lihaolun201003/challenging-course/build_ppt/media/screen_real.jpg

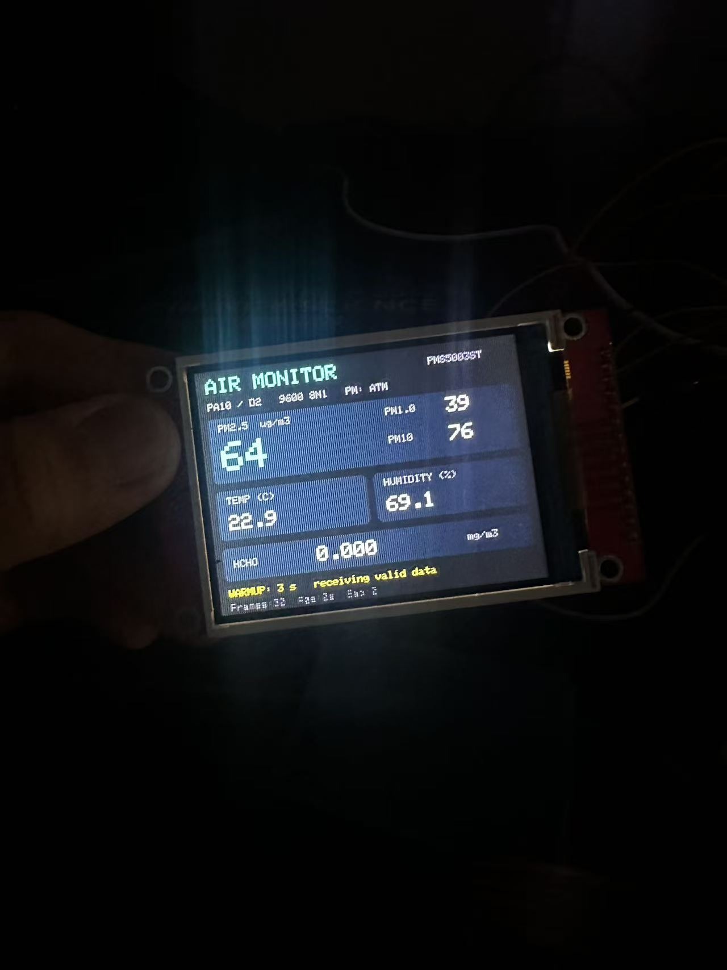
build_ppt/media/screen_real.jpg
