lihaolun201003/challenging-course/build_ppt/media/pcb_layout_early.jpg

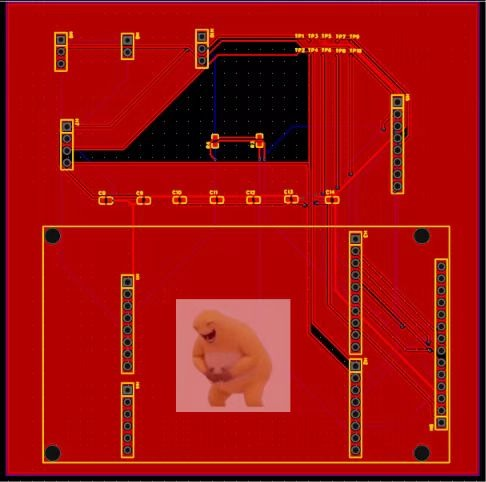
build_ppt/media/pcb_layout_early.jpg
