lihaolun201003/challenging-course/3D外壳打印/外壳初稿_方案A/README.txt

外壳初稿 · 方案 A（v3 · 上盖开显示窗口，屏从外面直接可见）
====================================================================
生成工具：3D 打印外壳生成器｜浮光工具库（内嵌 PrintCasing v0.9.7）
生成日期：2026-10-15

一、这一版做了什么
--------------------------------------------------------------
你要“壳外面正好能露出来显示屏”，所以：
  1. 上盖开了一个显示窗口（实测 68 × 54 mm，见第四节为什么不是 62 × 48）；
  2. 屏幕模块（2.8″ ILI9341，红色 PCB 带排针那款）改到**上盖内侧**、
     与窗口同心，从外面直接看见，不用拆盖；
  3. 外壳加长到 118 mm，把窗口完整放进上盖平面内（不切到墙边）。

二、文件说明
--------------------------------------------------------------
STL\01_底座_带铜柱.stl          底座：Nucleo-64 四铜柱 + 4 个角部螺丝柱        ← 主用
STL\01_上盖_带显示窗口.stl       上盖：显示窗口 + 唇边 + 4 螺丝孔              ← 主用
STL\02_底座_备用版.stl           备用：只保留角螺丝柱，铜柱位置你自己定
STL\02_上盖_备用版.stl           备用：与主用上盖相同（副本）
预览图\外壳_爆炸图.png           应用内截图（看得见上盖的窗口）
预览图\外壳_合盖图.png           应用内截图（合盖）

三、完整参数
--------------------------------------------------------------
[外壳]
  宽度 X ................... 130 mm
  长度 Y ................... 118 mm      （比上一版 +13，为窗口让位）
  高度 Z ................... 50 mm
  壁厚 T ................... 2.4 mm
  圆角半径 ................. 8 mm
  上盖公差 ................. 0.2 mm

[上盖]
  厚度 2.4 mm；唇边 1.6 / 1.5 mm；角部 M3 螺丝固定

[显示窗口]
  位置 ..................... 上盖（开孔 → 目标墙面 = 上盖）
  界面填写 ................. 矩形 62 × 48 mm，中心 x = 0、离前缘 30 mm
  实测结果 ................. 68.0 × 54.0 mm，中心 (0, +22)，即
                             Y 方向 5.0 ~ 59.0 mm（见第四节）

[PCB 安装]
  STM32 Nucleo-64 预设（孔距 70 × 50 mm）；底座内底面；旋转 90°；
  铜柱高 8 mm；中心偏移 Y = −28 mm（板子前移，后腔走线）

[通风] 本版未开槽（原因见第五节）

四、为什么界面填 62×48、实测却是 68×54
--------------------------------------------------------------
这个工具的开孔位置/尺寸有一套隐含换算，我做了 4 组标定实验才量准：
  · 宽度方向：实测宽 = 壳宽 − 填写宽。填 62 → 68 mm。想精确要 62，
    需要把宽度填成 68（但那会让窗口几乎占满上盖宽度，反而危险）。
  · 高度方向：填 48 → 实测 54；填 42 → 48。所以**高度是准的、宽度有 +6 的偏差**。
  · 位置：填写 z 控制窗口中心到前缘的距离。
结论：本版取“宁大不小”——窗口 68 × 54，屏幕可视区 57.6 × 43.2 一定能完整露出，
四周留 5 mm 左右遮边。**如果你要窗口刚好 62 × 48**，把宽度改成 68、
高度改成 42 再导出一版即可，或者告诉我，我帮你出。

五、几何自检（实测）
--------------------------------------------------------------
底座：3,082 三角面，包围盒 130.000 × 118.000 × 50.000 mm，体积 103.68 cm³，
      零退化三角形，1e-4 精度下 4 条缝合边（0.001 mm 量级，切片器自动缝合）。
上盖：1,404 三角面，体积 33.83 cm³，零退化三角形，窗口干净、无水密性障碍。
界面读数一致：底座 128.6 g + 上盖 42.0 g = 170.6 g（PLA 1.24 g/cm³）。

六、传感器（PMS5003ST）通风 —— 仍留给你手工做
--------------------------------------------------------------
原因同上一版：这个工具的“通风槽”是居中贯穿整块板的，一开就切进窗口区域。
位置建议（上盖后半区，窗口后沿之后）：
  X 左右各 15 ~ 40 mm、Y 窗口后沿 +5 ~ 到内壁前 5 mm 范围内，
  开 6 ~ 8 个 Ø3 ~ 4 mm 圆孔，左右两排、前后错开；传感器就挂在这一片内侧。
做法：① 手电钻按位置打；② 切片软件“负零件/修改器”加孔后重切片（推荐，不引入缝合边）；
      ③ 要工具直接生成，就把外壳再拉长、让槽居中落在窗口之外，我帮你出。

七、装配要点
--------------------------------------------------------------
0. 先量实物再打第一版：① Nucleo 两块板孔距（70×50 还是 70×63.5）；
   ② 屏幕模块的四个安装孔距。量完告诉我，我按实测改。
1. 屏幕固定：模块外框约 58 × 87 mm（按实物照像素折算，误差 ±2 mm）。
   模块四角用 M3 尼龙柱/铜柱固定在上盖内侧，或用打印压条压住；
   屏幕面与窗口之间留 1 mm 泡棉垫，防尘缓冲。
2. 屏幕排线从窗口后沿走到后腔，再经侧墙缺口进底盒接 Nucleo。
3. 铜柱中心 ±25 / ±35 mm，距内壁约 0.4 mm，装板注意别顶到圆角。
4. Nucleo 的 USB、传感器线束、蜂鸣器声孔按实机位置自己开。

八、下一步
--------------------------------------------------------------
- 想要“窗口刚好 62×48”：填宽度 68、高度 42 重新导出（或用我给的参数）。
- 想要“屏幕面凸出上盖 1~2 mm”的面板样式：把铜柱高度从 8 调到 10~12 再导出。
- 需要我把通风孔直接做进 STL（外壳再加长 20 mm）或改成屏幕外凸样式，说一声。
