lihaolun201003/challenging-course/02_固件工程/AIR/docs/Naiwa-companion-ui.md

# 奶娃陪伴固件：已修改并烧录

烧录完成：2026-10-16T00:03:29.032617+08:00。

已将“奶娃陪伴”界面接入工程 `C:\Users\lihao\Desktop\挑战性课程\02_固件工程\AIR`，并通过ST-Link烧录到当前连接的NUCLEO-F411RE。
界面为320×240横屏，奶油黄背景，左侧奶娃与中文状态，右侧六参数对齐读数，底部真实数据年龄及蓝牙上报状态。角色默认静态，数字和状态按变化局部更新。原启动动画保留。

## 验证结果

- PlatformIO环境：nucleo_f411re_uart6，构建成功。
- 固件BIN：329312字节；Flash报告328856/524288，RAM报告89016/131072。
- OpenOCD显示Verified OK；烧录后读回完整应用范围，与BIN逐字节一致。
- 新UI标识和BOOT monitor: ready均出现，启动次数1。
- 115200 8N1、COM3，连续观察45秒，收到48帧；帧号连续，传感器ERR非零次数0。
- 诊断记录8条；校验错误、长度错误、半帧超时均为0。
- 最后一帧：PM1.0=30、PM2.5=48、PM10=58 µg/m³，温度22.7°C，湿度68.4%RH，甲醛0.000 mg/m³。这是烧录后运行检查，不是新的10分钟实验。
- 原有文件只修改src/main.cpp；原传感器解析、蓝牙、报警逻辑、引脚配置和启动动画文件哈希保持一致。
- 未通过相机检查实屏画面；验证覆盖编译、实际烧录/读回与新固件运行日志。

## 文件与回退

- `air-naiwa-companion-uart6-20261016.bin/.elf`：实际烧录的新固件。
- `验证记录.json`：机器可读结果；烧录和串口日志另附。
- `源码改动.zip`：UI集成main与新增模块、资源生成脚本及角色源图。
- `烧录前备份.zip`：修改前完整Flash、源码和恢复说明。
- 工程内归档：firmware/air-naiwa-companion-uart6-20261016.bin、firmware/air-naiwa-companion-uart6-20261016.elf。
- 工程内备份：backups/before-naiwa-companion-20261015_235608。

新固件SHA-256：`bef9a11d3dc791f4b05b4394965e82e0bf207f11f094a73bd3b0560aed887c59`。
