lihaolun201003/challenging-course/00_整理记录/整理报告.md

# 整理记录

**整理日期**：本次会话
**整理范围**：`C:\Users\lihao\Desktop\挑战性课程`
**用户要求**：**都不删，就整理** —— 因此本次**没有删除任何一个文件**，只做搬迁、重命名与归类。

---

## 一、结果：零丢失（已逐字节校验）

整理前后对全部文件做了 SHA-256 指纹，逐一比对：

| | 文件数 | 总字节数 |
| --- | --- | --- |
| 整理前 | **2477** | **45,277,537** |
| 整理后 | **2477** | **45,277,537** |
| 丢失（有前无后） | **0** | — |
| 新增（有后无前） | **0** | — |

> 校验方法：遍历全部文件计算 SHA-256，用多重集（multiset）比对，
> 因此"内容相同但路径变了"不会被误判为丢失。
> 完整清单见同目录的 [文件清单_整理前.tsv](文件清单_整理前.tsv) 与 [文件清单_整理后.tsv](文件清单_整理后.tsv)。

唯一被移除的是**空目录** `AIR(1)\AIR\`（搬迁后剩下 0 个文件的外壳）。

> 说明：外层空壳 `AIR(1)\` 当时被系统的其他进程占用（Explorer / 索引器持有句柄），
> 未能删除，现在仍留在根目录，**里面 0 个文件**，你可以直接手动删掉它。

---

## 二、搬迁对照表

### 根目录散落文件 → 分类目录

| 原路径 | 新路径 | 说明 |
| --- | --- | --- |
| `挑战性课程开题报告.pptx` | `01_报告/01_开题报告.pptx` | |
| `挑战性课程阶段性报告.pptx` | `01_报告/02_阶段性报告.pptx` | |
| `演示文稿1(2).pptx` | `01_报告/03_PCB迭代记录.pptx` | 内容是 PCB 原理图 + 三版布局 |
| `document.tex` | `03_外设接口说明/外设接口分配表.tex` | 内容未改 |
| `stm32.pdf` | `04_资料/NUCLEO-64_用户手册.pdf` | 91 页 |
| `显示屏.pdf` | `04_资料/ILI9341_显示屏资料.pdf` | 8 页 |
| `4cfd53e59920ec299d00e6085c6228a6.png` | `05_素材/APP_MIT_AppInventor设计界面.jpg` | 改名 + **修正错误扩展名** |
| `微信图片_20260922125235_5_2.jpg` | `05_素材/APP_手机运行截图.jpg` | 改名 |
| `8d35c32eb0cca47f893ce5399ef7c01f.jpg` | `05_素材/实物_屏幕实时读数.jpg` | 改名 |
| `微信图片_20260922125316_6_2.jpg` | `05_素材/PCB_布局截图.jpg` | 改名 |
| `d50e7ac4a7a0a84cb1c2305e1b7adbf0.mp4` | `05_素材/实物演示视频.mp4` | 改名 |

### 固件工程

| 原路径 | 新路径 | 说明 |
| --- | --- | --- |
| `AIR(1)\AIR\AIR\` | `02_固件工程\AIR\` | **去掉两层多余嵌套**，工程内部结构一个文件都没动 |

---

## 三、新建的文件（全部是新增说明文档，未覆盖任何原文件）

| 文件 | 作用 |
| --- | --- |
| `README.md`（根目录） | 总导航 + 三十秒上手 + 已知待修正事项 |
| `00_整理记录/整理报告.md` | 本文件 |
| `00_整理记录/文件清单_整理前.tsv` / `_整理后.tsv` | 零丢失校验的原始数据 |
| `05_素材/清单.md` | 每张图 / 视频的内容、尺寸、是否已嵌入 PPT |
| `02_固件工程/AIR/firmware/MANIFEST.md` | 12 个固件产物 ↔ PlatformIO 环境 ↔ SHA-256 ↔ 验证日志 |
| `02_固件工程/AIR/logs/README.md` | 46 个日志按 9 组归类索引 |

另：根目录初始化了一个 **git 仓库**并提交了整理前的完整快照
（commit `4e0494d` "整理前快照：原样保存 2477 个文件"），作为本次搬迁的撤销点。
**不需要的话直接删掉 `.git` 文件夹即可**，不影响任何内容。
（`.pio` 构建缓存按工程原有的 .gitignore 规则未纳入版本管理。）

---

## 四、明确没做的事

本次严格遵循"都不删、就整理"，以下一律**未改动**：

- ❌ 未删除任何文件
- ❌ 未修改任何原有文件的内容（含 PPT、PDF、.tex、源码、日志）
- ❌ 未修改 `src/`、`include/`、`test/`、`platformio.ini`
- ❌ 未修改 `backups/` 里 8 个快照的内容
- ❌ 未清理 `.pio` 构建缓存（虽然它是可再生的，但你说不删）
- ❌ 未修正 `document.tex` 的引脚错误、未修正 PPT 笔误（只在根 README 里记录下来）

---

## 五、搬迁后回归验证

| 项目 | 结果 |
| --- | --- |
| 在新位置编译默认固件 | ✅ `pio run -e nucleo_f411re_uart6` → **SUCCESS**（全量重建 6.94 s） |
| 资源占用是否变化 | ✅ 与搬迁前完全一致：Flash **48144 B (9.2%)**、静态 RAM **8988 B (6.9%)** |
| 重建产物与存档固件是否一致 | ✅ SHA-256 均为 `46f820447f180d37c6e09040c288e3cfa7c6b1ff00bfdb3798784ae9f17a162d` —— **字节完全相同** |
| 中文路径是否有影响 | ✅ 无影响（工程自带 `scripts/windows_paths.py` 处理 Unicode 链接路径） |

---

## 六、遗留事项

见根目录 [README.md](../README.md) 的"⚠️ 已知待修正事项"一节，共 5 条，
其中优先建议处理的是 **`外设接口分配表.tex` 与当前固件接线不一致**
（蓝牙串口、LCD 的 DC/RESET/背光、PMS 的 SET/RESET 都对不上）。
