lihaolun201003/challenging-course/02_固件工程/数据包/光电楼_20261021_151032/summary.md

# 串口采集观察摘要

> 仅描述记录到的现象；不设置通过标准，不验证传感器精度。

- 数据：`measurements.csv`，共 **642** 行；保留零值，不插值、不滤波、不删除异常读数。
- 元数据正式窗口：2026-10-21T15:11:03.303+08:00 至 2026-10-21T15:21:03.303+08:00；声明时长 **600 s**。
- 实际首末读数：**2026-10-21T15:11:03.697+08:00** 至 **2026-10-21T15:21:02.942+08:00**。
- 样本覆盖：**599.2451 s**（elapsed_s）；首末样本跨度与正式计时窗口分别记录，二者可以不同。
- 元数据原值：source_code_unchanged=—；flash_verified=—。缺失/未确认不视为true。

## 数值统计

| 参数 | 单位 | 数值数 | 零值数 | 最小 | 最大 | 平均 | 样本标准差 | 缺失/非法 |
| --- | --- | ---: | ---: | ---: | ---: | ---: | ---: | ---: |
| PM1.0 | µg/m³ | 642 | 554 | 0 | 19 | 0.7165 | 3.0396 | 0/0 |
| PM2.5 | µg/m³ | 642 | 492 | 0 | 29 | 1.1589 | 4.6379 | 0/0 |
| PM10 | µg/m³ | 642 | 486 | 0 | 32 | 1.2508 | 5.0718 | 0/0 |
| 甲醛 HCHO | mg/m³ | 642 | 642 | 0 | 0 | 0 | 0 | 0/0 |
| 温度 | °C | 642 | 0 | 19.8 | 20.8 | 20.3693 | 0.2809 | 0/0 |
| 相对湿度 | % | 642 | 0 | 56.6 | 62.1 | 60.1713 | 0.9459 | 0/0 |

标准差使用ddof=1；缺失/非数值/非有限值如实计数，不转成0。原始CSV不被修改。

## 主机接收间隔与帧编号

- 相邻接收间隔 min / median / max / p95：**0.9011 / 0.9083 / 0.9851 / 0.9791 s**；p95使用nearest-rank。
- 窗口起点至首样：0.394 s；末样至窗口终点：0.3609 s；包含两端的最长可观察无读数区间：**0.9851 s**。
- 达到或超过10秒的区间共 **0** 个（含可评估的窗口边缘）；明细见summary.json。
- 零间隔 0 次；负间隔 0 次；时间无法比较的相邻记录 0 对。
- 帧编号首/末：403 / 1044；相邻重复 0 次，向前跳号 0 次（未见编号 0 个），回退 0 次。
- ERR非零 **0** 次；ERR缺失/非法 0 次；固件版本原值分布：`{"145": 642}`。

## 原始诊断计数

全部诊断记录：2026-10-21T15:10:37.600+08:00 → 2026-10-21T15:21:07.605+08:00，记录跨度 630.0059 s。

| 原始累计项 | 首值 | 末值 | 末减首 | 期间回退次数 |
| --- | ---: | ---: | ---: | ---: |
| 接收字节数 | 15000 | 41941 | 26941 | 0 |
| 有效帧数 | 375 | 1048 | 673 | 0 |
| 校验错误数 | 0 | 0 | 0 | 0 |
| 长度错误数 | 0 | 0 | 0 | 0 |
| 半帧超时数 | 0 | 0 | 0 | 0 |

仅phase=test的记录：2026-10-21T15:11:07.600+08:00 → 2026-10-21T15:21:02.606+08:00，记录跨度 595.0058 s。

| 原始累计项 | 首值 | 末值 | 末减首 | 期间回退次数 |
| --- | ---: | ---: | ---: | ---: |
| 接收字节数 | 16280 | 41720 | 25440 | 0 |
| 有效帧数 | 407 | 1043 | 636 | 0 |
| 校验错误数 | 0 | 0 | 0 | 0 |
| 长度错误数 | 0 | 0 | 0 | 0 |
| 半帧超时数 | 0 | 0 | 0 | 0 |

测试边缘外包记录：2026-10-21T15:11:02.600+08:00 → 2026-10-21T15:21:07.605+08:00，记录跨度 605.0057 s。

| 原始累计项 | 首值 | 末值 | 末减首 | 期间回退次数 |
| --- | ---: | ---: | ---: | ---: |
| 接收字节数 | 16040 | 41941 | 25901 | 0 |
| 有效帧数 | 401 | 1048 | 647 | 0 |
| 校验错误数 | 0 | 0 | 0 | 0 |
| 长度错误数 | 0 | 0 | 0 | 0 |
| 半帧超时数 | 0 | 0 | 0 | 0 |

## 边界与解释

- 正式计时窗口来自元数据，实际样本覆盖来自首末CSV读数，两者不是同一时长；不足600秒的样本跨度不自动否定600秒采集窗口。
- 全部measurements.csv记录参与分析；不插值、不平滑、不重采样、不删除零或ERR非零读数。非法/缺失值保持缺失并单列数量。
- 相邻主机接收间隔优先由elapsed_s相减；不可用时才用可比较的timestamp_local，不推测缺失时区。
- 最长可观察无读数区间同时检查首样之前、相邻样本之间和末样之后；未提供时长或时间异常时，边缘结果可能不可完整评估。
- 主机收到日志的时间不是传感器采样时间；串口缓冲、日志调度及主机接收都可能影响间隔。
- 诊断计数是设备累计原值；phase=test的首末诊断未必正好落在计时边界，边缘外包差值又可能包含少量窗口外时间。
- 计数增量只做末值减首值，不在重置/回绕时猜测或补算。age_ms是瞬时末帧年龄，不是累计错误数。
- 零诊断错误、没有编号跳号，不等于传感器零丢包，也不等于传感器精度、校准、长期稳定性或硬件正确性已验证。

## 记录告警

- 未发现本脚本列举的记录异常；这不是通过判定。
