lihaolun201003/challenging-course/02_固件工程/数据包/文科楼_20261028_151043/summary.md

# 串口采集观察摘要

> 仅描述记录到的现象；不设置通过标准，不验证传感器精度。

- 数据：`measurements.csv`，共 **191** 行；保留零值，不插值、不滤波、不删除异常读数。
- 元数据正式窗口：2026-10-28T15:11:14.444+08:00 至 2026-10-28T15:21:14.444+08:00；声明时长 **600 s**。
- 实际首末读数：**2026-10-28T15:11:14.913+08:00** 至 **2026-10-28T15:14:12.424+08:00**。
- 样本覆盖：**177.5108 s**（elapsed_s）；首末样本跨度与正式计时窗口分别记录，二者可以不同。
- 元数据原值：source_code_unchanged=—；flash_verified=—。缺失/未确认不视为true。

## 数值统计

| 参数 | 单位 | 数值数 | 零值数 | 最小 | 最大 | 平均 | 样本标准差 | 缺失/非法 |
| --- | --- | ---: | ---: | ---: | ---: | ---: | ---: | ---: |
| PM1.0 | µg/m³ | 191 | 79 | 0 | 3 | 0.7749 | 0.7585 | 0/0 |
| PM2.5 | µg/m³ | 191 | 68 | 0 | 3 | 0.9215 | 0.8392 | 0/0 |
| PM10 | µg/m³ | 191 | 68 | 0 | 4 | 1.0576 | 1.0671 | 0/0 |
| 甲醛 HCHO | mg/m³ | 191 | 0 | 1.266 | 1.579 | 1.4076 | 0.0904 | 0/0 |
| 温度 | °C | 191 | 0 | 18.2 | 18.5 | 18.3738 | 0.0714 | 0/0 |
| 相对湿度 | % | 191 | 0 | 63.1 | 63.5 | 63.2958 | 0.0911 | 0/0 |

标准差使用ddof=1；缺失/非数值/非有限值如实计数，不转成0。原始CSV不被修改。

## 主机接收间隔与帧编号

- 相邻接收间隔 min / median / max / p95：**0.8921 / 0.9083 / 0.9876 / 0.9793 s**；p95使用nearest-rank。
- 窗口起点至首样：0.469 s；末样至窗口终点：422.0202 s；包含两端的最长可观察无读数区间：**422.0202 s**。
- 达到或超过10秒的区间共 **1** 个（含可评估的窗口边缘）；明细见summary.json。
- 零间隔 0 次；负间隔 0 次；时间无法比较的相邻记录 0 对。
- 帧编号首/末：109 / 299；相邻重复 0 次，向前跳号 0 次（未见编号 0 个），回退 0 次。
- ERR非零 **0** 次；ERR缺失/非法 0 次；固件版本原值分布：`{"145": 191}`。

## 原始诊断计数

全部诊断记录：2026-10-28T15:10:48.678+08:00 → 2026-10-28T15:14:08.678+08:00，记录跨度 200.0001 s。

| 原始累计项 | 首值 | 末值 | 末减首 | 期间回退次数 |
| --- | ---: | ---: | ---: | ---: |
| 接收字节数 | 3240 | 11760 | 8520 | 0 |
| 有效帧数 | 81 | 294 | 213 | 0 |
| 校验错误数 | 0 | 0 | 0 | 0 |
| 长度错误数 | 0 | 0 | 0 | 0 |
| 半帧超时数 | 0 | 0 | 0 | 0 |

仅phase=test的记录：2026-10-28T15:11:18.679+08:00 → 2026-10-28T15:14:08.678+08:00，记录跨度 169.9999 s。

| 原始累计项 | 首值 | 末值 | 末减首 | 期间回退次数 |
| --- | ---: | ---: | ---: | ---: |
| 接收字节数 | 4520 | 11760 | 7240 | 0 |
| 有效帧数 | 113 | 294 | 181 | 0 |
| 校验错误数 | 0 | 0 | 0 | 0 |
| 长度错误数 | 0 | 0 | 0 | 0 |
| 半帧超时数 | 0 | 0 | 0 | 0 |

测试边缘外包记录：2026-10-28T15:11:13.678+08:00 → 2026-10-28T15:14:08.678+08:00，记录跨度 175.0001 s。

| 原始累计项 | 首值 | 末值 | 末减首 | 期间回退次数 |
| --- | ---: | ---: | ---: | ---: |
| 接收字节数 | 4280 | 11760 | 7480 | 0 |
| 有效帧数 | 107 | 294 | 187 | 0 |
| 校验错误数 | 0 | 0 | 0 | 0 |
| 长度错误数 | 0 | 0 | 0 | 0 |
| 半帧超时数 | 0 | 0 | 0 | 0 |

## 边界与解释

- 正式计时窗口来自元数据，实际样本覆盖来自首末CSV读数，两者不是同一时长；不足600秒的样本跨度不自动否定600秒采集窗口。
- 全部measurements.csv记录参与分析；不插值、不平滑、不重采样、不删除零或ERR非零读数。非法/缺失值保持缺失并单列数量。
- 相邻主机接收间隔优先由elapsed_s相减；不可用时才用可比较的timestamp_local，不推测缺失时区。
- 最长可观察无读数区间同时检查首样之前、相邻样本之间和末样之后；未提供时长或时间异常时，边缘结果可能不可完整评估。
- 主机收到日志的时间不是传感器采样时间；串口缓冲、日志调度及主机接收都可能影响间隔。
- 诊断计数是设备累计原值；phase=test的首末诊断未必正好落在计时边界，边缘外包差值又可能包含少量窗口外时间。
- 计数增量只做末值减首值，不在重置/回绕时猜测或补算。age_ms是瞬时末帧年龄，不是累计错误数。
- 零诊断错误、没有编号跳号，不等于传感器零丢包，也不等于传感器精度、校准、长期稳定性或硬件正确性已验证。

## 记录告警

- [host_gap_ge_10s] 主机记录出现1个≥10秒无读数区间（含窗口边缘）；这不直接证明传感器停止输出。
