lihaolun201003/challenging-course/3D外壳打印/3D打印PCB外壳生成器/3D打印外壳生成器-浮光工具库-win32-x64/使用说明.txt

3D 打印外壳生成器｜浮光工具库（Windows 离线中文版）

完整解压后双击应用程序打开。支持参数化设计电子设备外壳并导出 3D 打印文件。
无需联网，设计数据保留在本机。请保持文件夹内容完整。
