lihaolun201003/challenging-course/01_报告/03_PCB迭代记录.pptx

## 迭代第一版


## 迭代第二版


## 迭代第三版

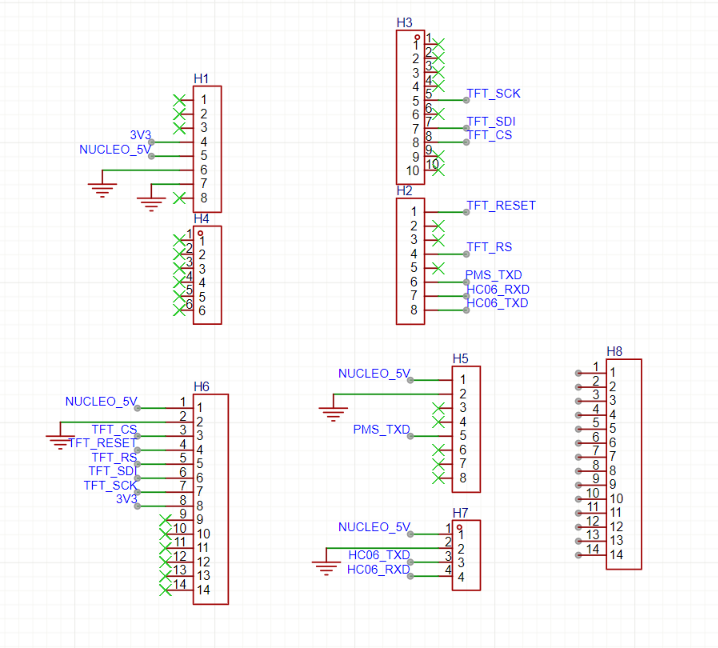
[picture p32: figure]
