lihaolun201003/challenging-course/02_固件工程/AIR/assets/boot-run-converted-preview.gif

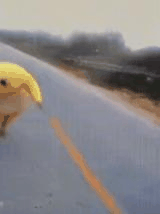
02_固件工程/AIR/assets/boot-run-converted-preview.gif
