lihaolun201003/challenging-course/02_固件工程/AIR/assets/naiwa-original.png

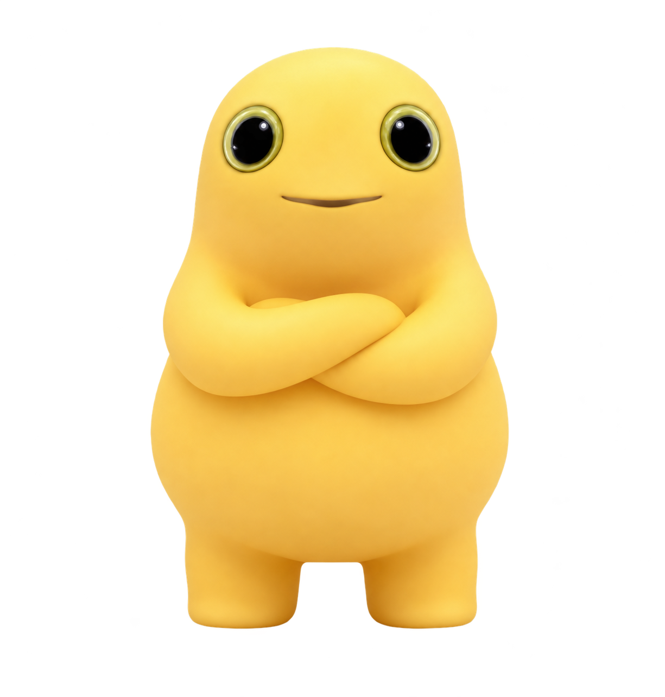
02_固件工程/AIR/assets/naiwa-original.png
