lihaolun201003/challenging-course/02_固件工程/数据包/光电楼_20261021_151032/plots/six_parameters.png

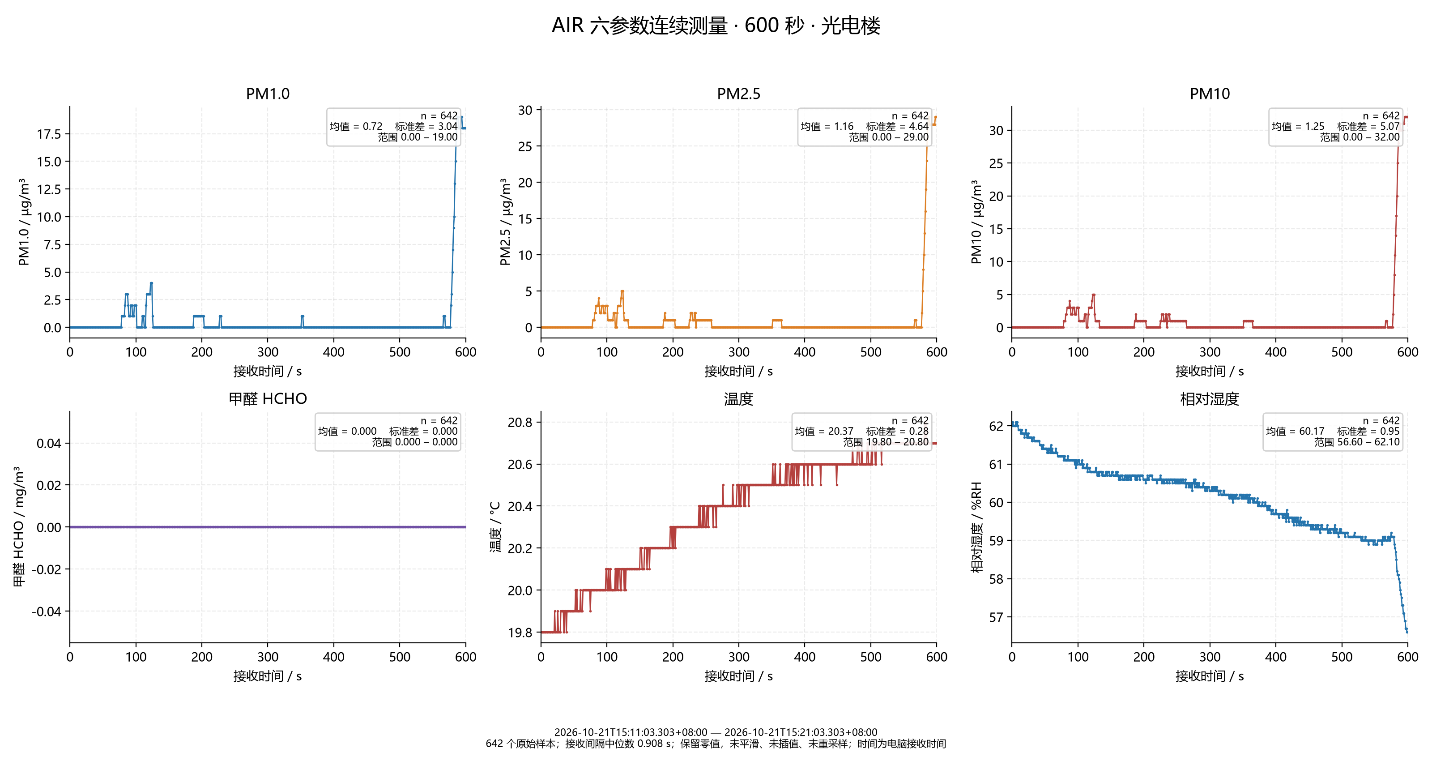
02_固件工程/数据包/光电楼_20261021_151032/plots/six_parameters.png
