lihaolun201003/challenging-course/02_固件工程/数据包/文科楼_20261028_151043/plots/six_parameters.png

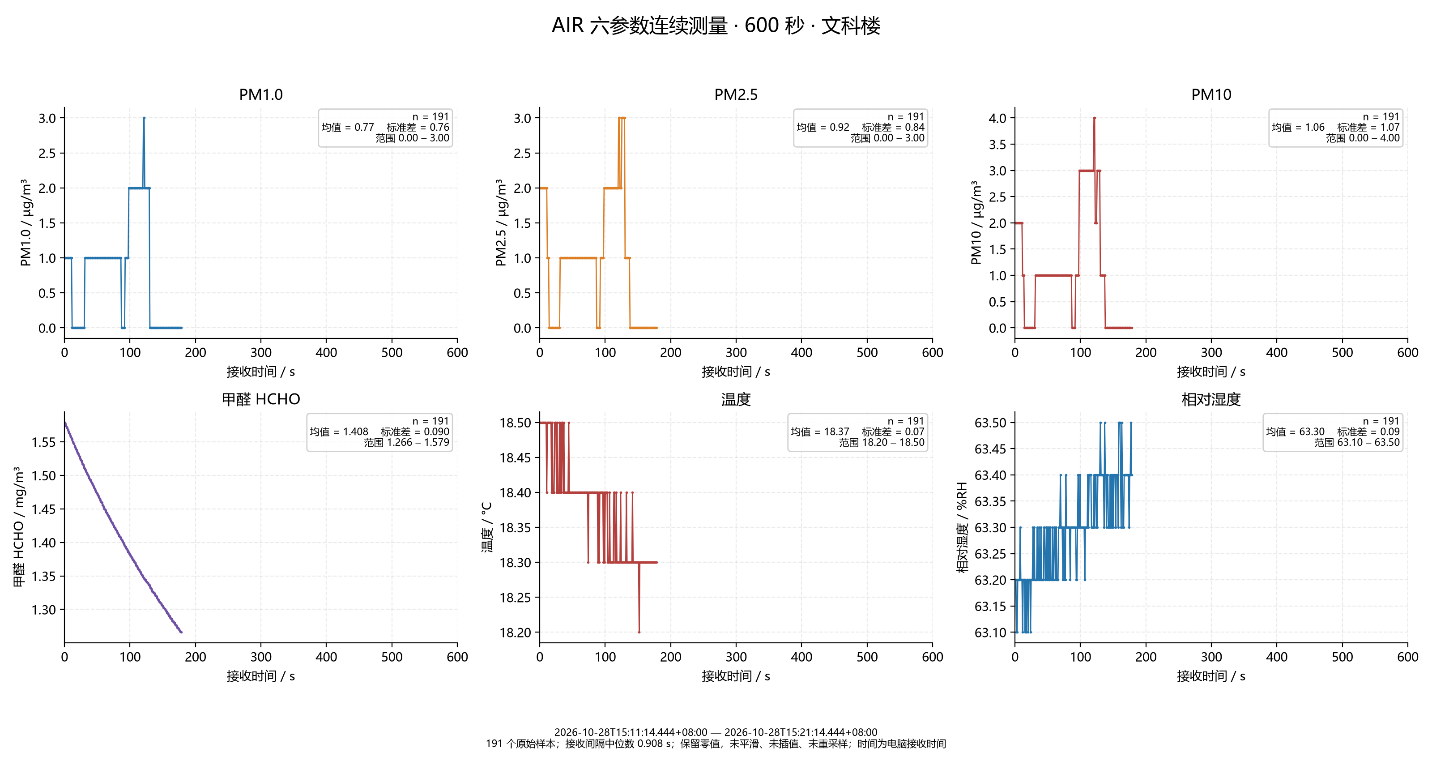
02_固件工程/数据包/文科楼_20261028_151043/plots/six_parameters.png
