lihaolun201003/challenging-course/02_固件工程/数据包/有毒气体特定场景_20261028_144738/plots/six_parameters.png

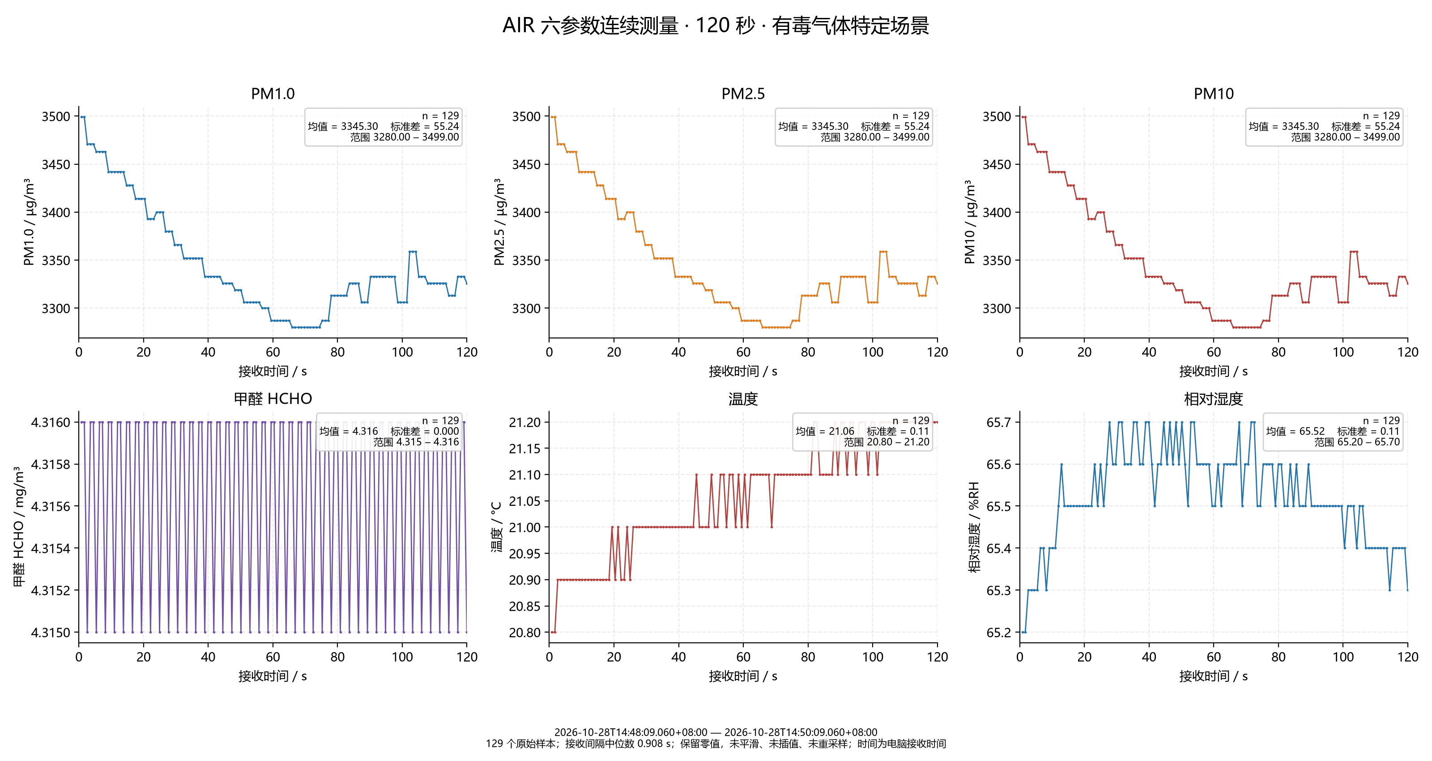
02_固件工程/数据包/有毒气体特定场景_20261028_144738/plots/six_parameters.png
