lihaolun201003/challenging-course/3D外壳打印/外壳初稿_方案A/预览图/外壳_合盖图.png

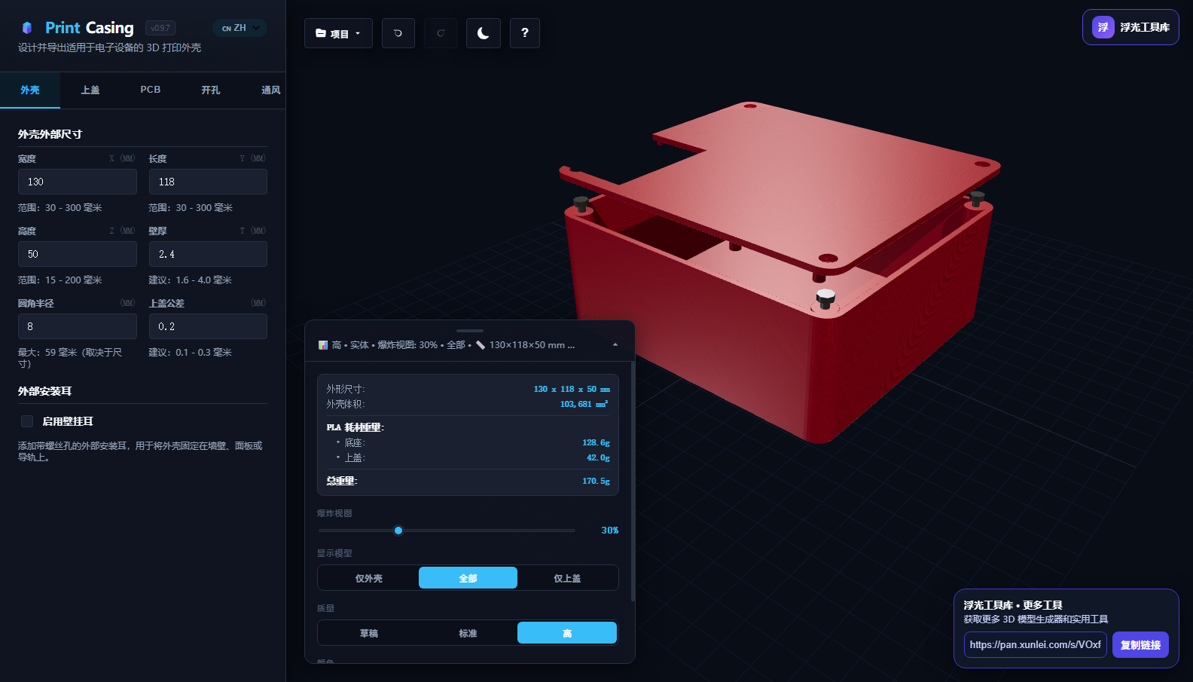
3D外壳打印/外壳初稿_方案A/预览图/外壳_合盖图.png
