lihaolun201003/challenging-course/05_素材/APP_MIT_AppInventor设计界面.jpg

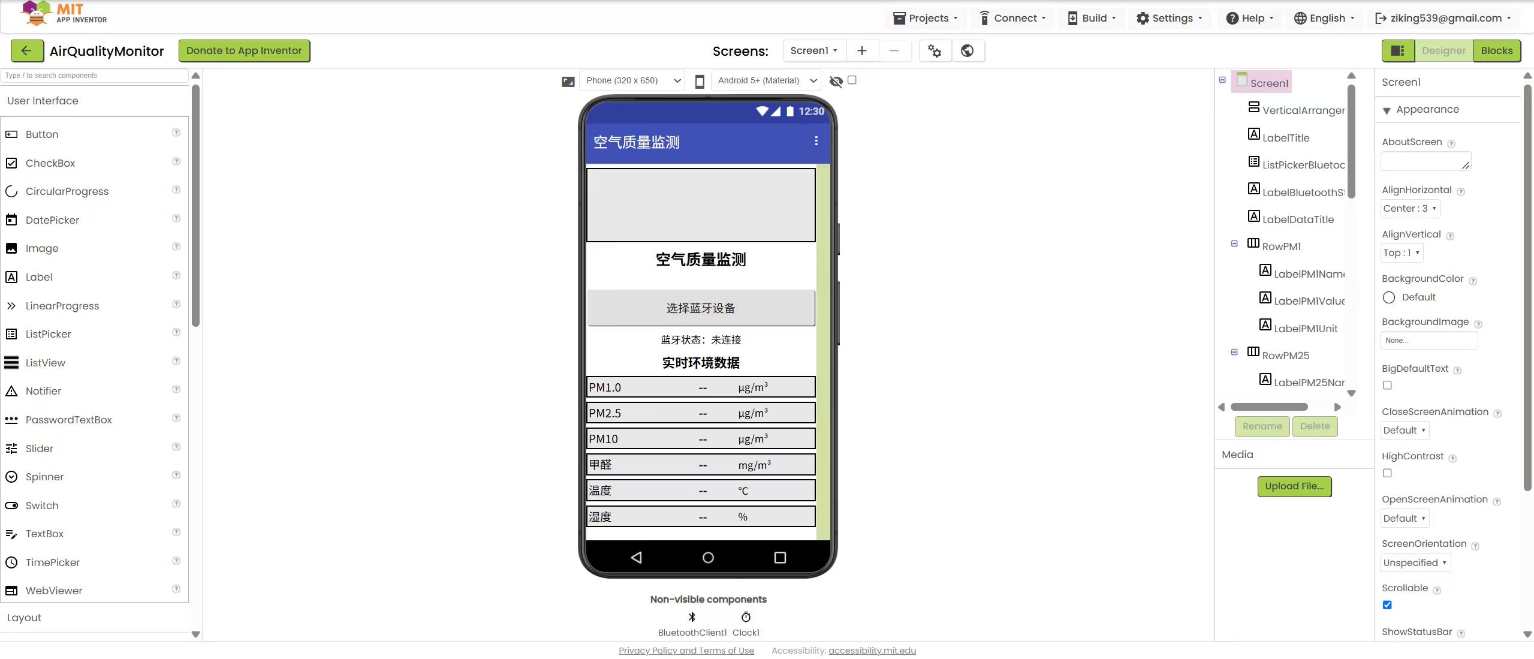
05_素材/APP_MIT_AppInventor设计界面.jpg
