lihaolun201003/challenging-course/05_素材/APP_手机运行截图.jpg

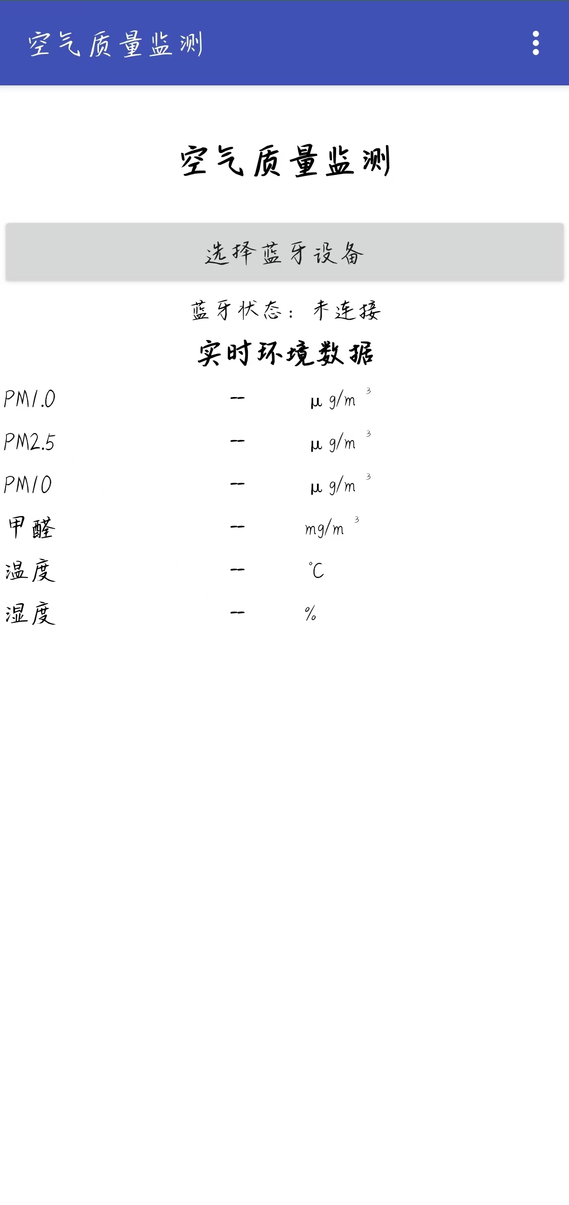
05_素材/APP_手机运行截图.jpg
