lihaolun201003/challenging-course/05_素材/diagram.png

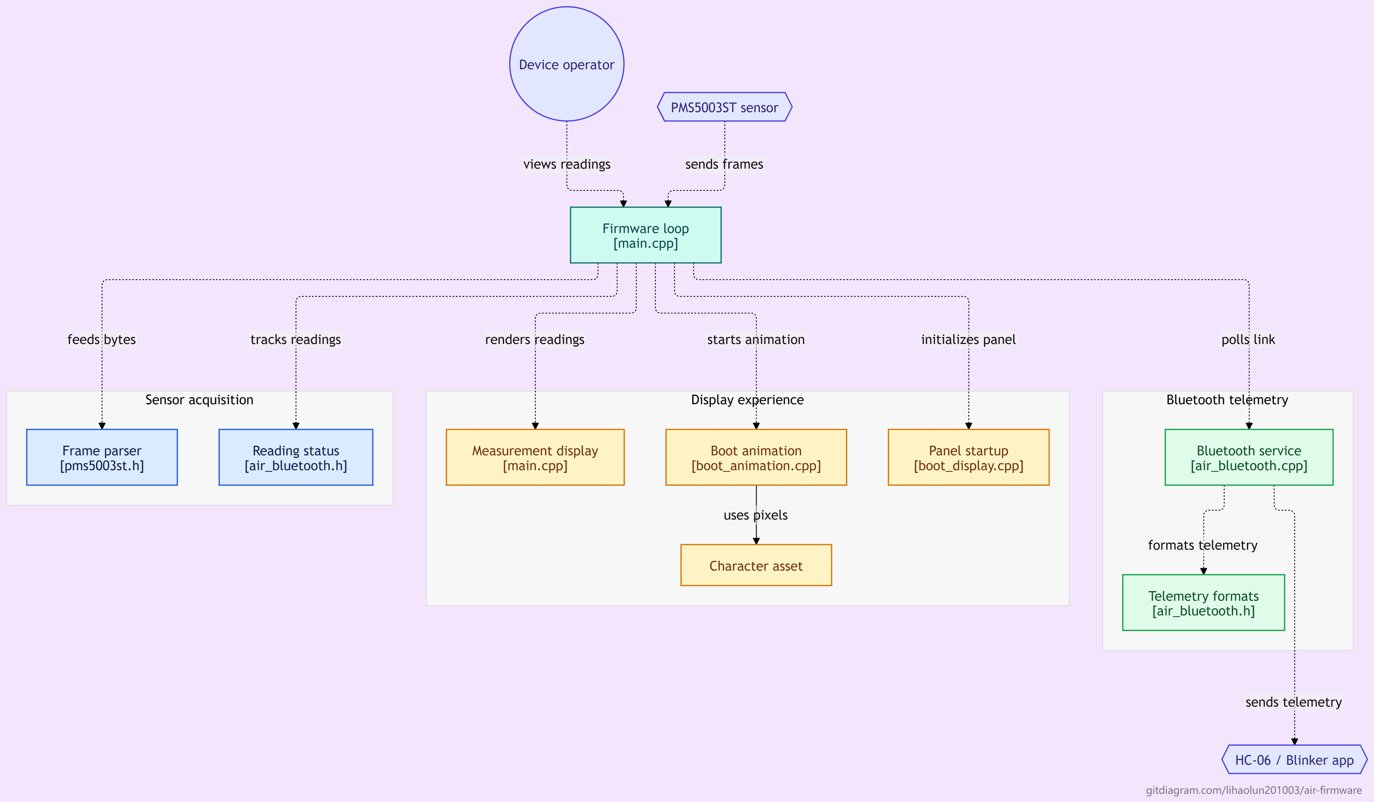
05_素材/diagram.png
