lihaolun201003/challenging-course/05_素材/清单.md

# 素材清单

本目录 4 张图 + 1 段视频。文件名已改为能看懂的名字，原名记在下表"原文件名"列。

| 文件名 | 原文件名 | 尺寸 / 时长 | 实际内容 | 是否已嵌入 PPT |
| --- | --- | --- | --- | --- |
| [APP_MIT_AppInventor设计界面.jpg](APP_MIT_AppInventor设计界面.jpg) | `4cfd53e59920ec299d00e6085c6228a6.png` | 2559×1099 · 217 KB | MIT App Inventor 设计视图截图：AirQualityMonitor 工程，左中右三栏（组件树 / 手机预览 / 属性面板），预览里显示六项读数的占位 | ✅ 开题报告 `ppt/media/image2.jpeg` |
| [APP_手机运行截图.jpg](APP_手机运行截图.jpg) | `微信图片_20260922125235_5_2.jpg` | 1219×2583 · 212 KB | 手机 APP 实机运行界面："空气质量监测"标题、选择蓝牙设备按钮、蓝牙状态：未连接，六项读数均为 `-` | ✅ 开题报告 `ppt/media/image3.jpeg` |
| [实物_屏幕实时读数.jpg](实物_屏幕实时读数.jpg) | `8d35c32eb0cca47f893ce5399ef7c01f.jpg` | 1280×1707 · 106 KB | **实拍硬件照片**：开发板点亮 TFT 屏，显示 AIR MONITOR / PMS5003ST，PM2.5 **64**、PM1.0 **39**、PM10 **76**、温度 **22.9 ℃**、湿度 **69.1 %**、HCHO **0.000 mg/m³**，底部 WARMUP 3 s | ❌ 未嵌入任何 PPT |
| [PCB_布局截图.jpg](PCB_布局截图.jpg) | `微信图片_20260922125316_6_2.jpg` | 486×482 · 38 KB | PCB 布局截图（红色板、Arduino Shield 扩展板），中间被贴了一张猩猩表情图挡住 logo | ❌ 未嵌入任何 PPT |
| [实物演示视频.mp4](实物演示视频.mp4) | `d50e7ac4a7a0a84cb1c2305e1b7adbf0.mp4` | 8.17 秒 · 1.0 MB · HEVC + 音轨 | ⚠️ **内容待确认** —— 本机没有 ffmpeg，无法抽帧查看，需你确认拍的是什么 | ❌ |

---

## ⚠️ 两处需要注意

### 1. 一个文件的扩展名原本是错的

`4cfd53e59920ec299d00e6085c6228a6.png` 的**真实格式是 JPEG**，只是被命名成了 `.png`。
这会导致部分图片查看器和程序读图时报错。整理时已改名为 `.jpg`——**文件内容一字未动**，
只改了文件名（SHA-256 保持 `88c5686b…` 不变）。

### 2. 有两张图和开题报告里的是同一份

`APP_MIT_AppInventor设计界面.jpg` 和 `APP_手机运行截图.jpg` 的 SHA-256 与
开题报告 PPT 内嵌的图片**完全相同**——它们本来就是往 PPT 里插图用的原始素材。
两张都保留了（你要求不删），如果不需要留底可以自行处理。

---

## PCB 迭代记录在哪？

PCB 的原理图和布局图**不在本目录**，在 [../01_报告/03_PCB迭代记录.pptx](../01_报告/03_PCB迭代记录.pptx)
（原名 `演示文稿1(2).pptx`）。里面 4 页：原理图 + 迭代第一版 / 第二版 / 第三版布局图。
