lihaolun201003/challenging-course/3D外壳打印/外壳初稿_方案A/STL/02_底座_备用版.stl

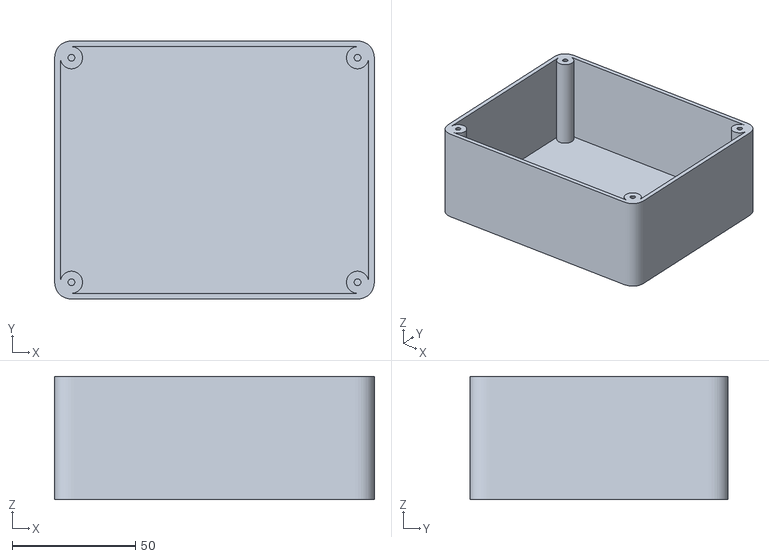
[picture p45: CAD file, 2026-11-05]
3D外壳打印/外壳初稿_方案A/STL/02_底座_备用版.stl
130.0 x 105.0 x 50.0
