lihaolun201003/challenging-course/3D外壳打印/外壳初稿_方案A/STL/02_上盖_备用版.stl

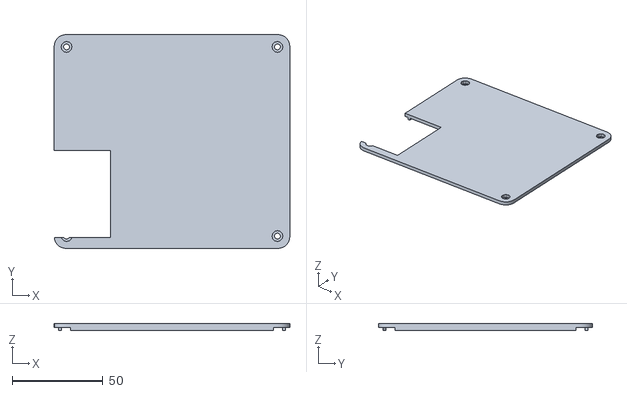
[picture p46: CAD file, 2026-11-05]
3D外壳打印/外壳初稿_方案A/STL/02_上盖_备用版.stl
130.0 x 118.0 x 4.00
