lihaolun201003/challenging-course/3D外壳打印/外壳初稿_方案A/STL/01_底座_带铜柱.stl

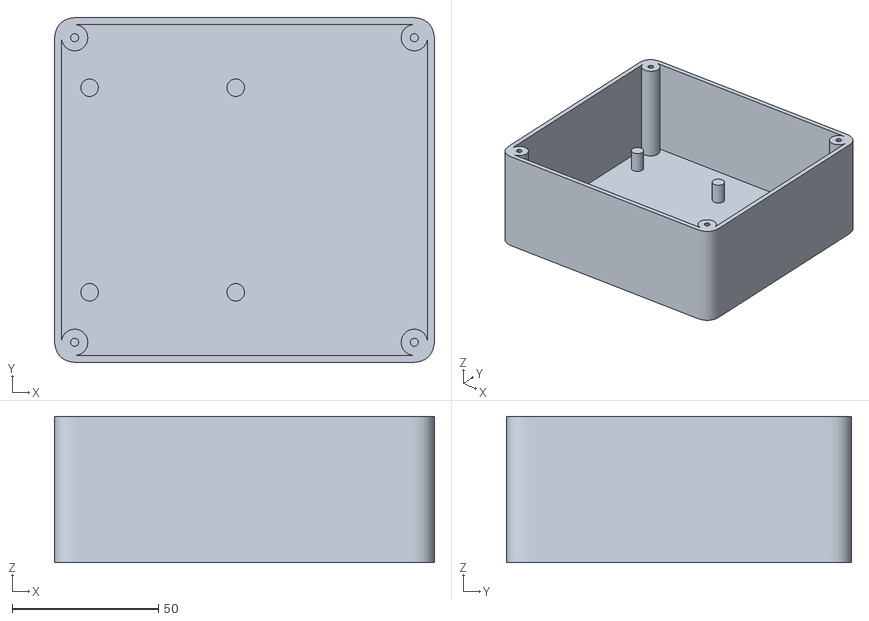
[picture p47: CAD file, 2026-11-05]
3D外壳打印/外壳初稿_方案A/STL/01_底座_带铜柱.stl
130.0 x 118.0 x 50.0
