lihaolun201003/challenging-course/02_固件工程/数据包/光电楼_20261021_151032/measurement_stats.csv

field | label_cn | unit | count | zero_count | min | max | mean | stdev | missing_count | invalid_or_nonfinite_count
pm1_ug_m3 | PM1.0 | µg/m³ | 642 | 554 | 0.0 | 19.0 | 0.7165109034267912 | 3.039625198697181 | 0 | 0
pm25_ug_m3 | PM2.5 | µg/m³ | 642 | 492 | 0.0 | 29.0 | 1.158878504672897 | 4.6378680064359585 | 0 | 0
pm10_ug_m3 | PM10 | µg/m³ | 642 | 486 | 0.0 | 32.0 | 1.250778816199377 | 5.0718126270453165 | 0 | 0
hcho_mg_m3 | 甲醛 HCHO | mg/m³ | 642 | 642 | 0.0 | 0.0 | 0.0 | 0.0 | 0 | 0
temperature_c | 温度 | °C | 642 | 0 | 19.8 | 20.8 | 20.36931464174455 | 0.28086532890944876 | 0 | 0
humidity_percent | 相对湿度 | % | 642 | 0 | 56.6 | 62.1 | 60.17133956386293 | 0.9459105246850518 | 0 | 0
