lihaolun201003/challenging-course/02_固件工程/数据包/光电楼_20261021_151032/measurements.csv

timestamp_local | elapsed_s | frame | pm1_ug_m3 | pm25_ug_m3 | pm10_ug_m3 | hcho_mg_m3 | temperature_c | humidity_percent | firmware_version | sensor_error
2026-10-21T15:11:03.697+08:00 | 0.39403970004059374 | 403 | 0 | 0 | 0 | 0.000 | 19.8 | 62.0 | 145 | 0
2026-10-21T15:11:04.605+08:00 | 1.3020083999726921 | 404 | 0 | 0 | 0 | 0.000 | 19.8 | 62.1 | 145 | 0
2026-10-21T15:11:05.513+08:00 | 2.210107000079006 | 405 | 0 | 0 | 0 | 0.000 | 19.8 | 62.0 | 145 | 0
2026-10-21T15:11:06.491+08:00 | 3.1880727999377996 | 406 | 0 | 0 | 0 | 0.000 | 19.8 | 62.0 | 145 | 0
2026-10-21T15:11:07.399+08:00 | 4.096201800042763 | 407 | 0 | 0 | 0 | 0.000 | 19.8 | 62.0 | 145 | 0
2026-10-21T15:11:08.307+08:00 | 5.004065599991009 | 408 | 0 | 0 | 0 | 0.000 | 19.8 | 62.0 | 145 | 0
2026-10-21T15:11:09.286+08:00 | 5.982984199887142 | 409 | 0 | 0 | 0 | 0.000 | 19.8 | 62.1 | 145 | 0
2026-10-21T15:11:10.194+08:00 | 6.891416999977082 | 410 | 0 | 0 | 0 | 0.000 | 19.8 | 62.0 | 145 | 0
2026-10-21T15:11:11.102+08:00 | 7.799307799898088 | 411 | 0 | 0 | 0 | 0.000 | 19.8 | 62.1 | 145 | 0
2026-10-21T15:11:12.080+08:00 | 8.777139900019392 | 412 | 0 | 0 | 0 | 0.000 | 19.8 | 62.0 | 145 | 0
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
