lihaolun201003/challenging-course/02_固件工程/数据包/文科楼_20261028_151043/measurement_stats.csv

field | label_cn | unit | count | zero_count | min | max | mean | stdev | missing_count | invalid_or_nonfinite_count
pm1_ug_m3 | PM1.0 | µg/m³ | 191 | 79 | 0.0 | 3.0 | 0.774869109947644 | 0.7585282554767304 | 0 | 0
pm25_ug_m3 | PM2.5 | µg/m³ | 191 | 68 | 0.0 | 3.0 | 0.9214659685863874 | 0.8392414793597089 | 0 | 0
pm10_ug_m3 | PM10 | µg/m³ | 191 | 68 | 0.0 | 4.0 | 1.057591623036649 | 1.0671321433158492 | 0 | 0
hcho_mg_m3 | 甲醛 HCHO | mg/m³ | 191 | 0 | 1.266 | 1.579 | 1.407607329842932 | 0.09040073211563755 | 0 | 0
temperature_c | 温度 | °C | 191 | 0 | 18.2 | 18.5 | 18.373821989528796 | 0.07141833568356477 | 0 | 0
humidity_percent | 相对湿度 | % | 191 | 0 | 63.1 | 63.5 | 63.295811518324605 | 0.09109420267704475 | 0 | 0
