lihaolun201003/challenging-course/02_固件工程/数据包/文科楼_20261028_151043/measurements.csv

timestamp_local | elapsed_s | frame | pm1_ug_m3 | pm25_ug_m3 | pm10_ug_m3 | hcho_mg_m3 | temperature_c | humidity_percent | firmware_version | sensor_error
2026-10-28T15:11:14.913+08:00 | 0.46904100000392646 | 109 | 1 | 2 | 2 | 1.579 | 18.5 | 63.2 | 145 | 0
2026-10-28T15:11:15.821+08:00 | 1.3771274000173435 | 110 | 1 | 2 | 2 | 1.577 | 18.5 | 63.2 | 145 | 0
2026-10-28T15:11:16.730+08:00 | 2.2853229999891482 | 111 | 1 | 2 | 2 | 1.574 | 18.5 | 63.1 | 145 | 0
2026-10-28T15:11:17.707+08:00 | 3.262834799999837 | 112 | 1 | 2 | 2 | 1.572 | 18.5 | 63.1 | 145 | 0
2026-10-28T15:11:18.616+08:00 | 4.171197400020901 | 113 | 1 | 2 | 2 | 1.571 | 18.5 | 63.2 | 145 | 0
2026-10-28T15:11:19.523+08:00 | 5.079138099972624 | 114 | 1 | 2 | 2 | 1.568 | 18.5 | 63.2 | 145 | 0
2026-10-28T15:11:20.503+08:00 | 6.058230699971318 | 115 | 1 | 2 | 2 | 1.565 | 18.5 | 63.2 | 145 | 0
2026-10-28T15:11:21.411+08:00 | 6.96619649999775 | 116 | 1 | 2 | 2 | 1.563 | 18.5 | 63.2 | 145 | 0
2026-10-28T15:11:22.318+08:00 | 7.874036299996078 | 117 | 1 | 2 | 2 | 1.562 | 18.5 | 63.3 | 145 | 0
2026-10-28T15:11:23.297+08:00 | 8.8523259999929 | 118 | 1 | 2 | 2 | 1.559 | 18.5 | 63.2 | 145 | 0
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
