lihaolun201003/challenging-course/02_固件工程/数据包/有毒气体特定场景_20261028_144738/measurement_stats.csv

field | label_cn | unit | count | zero_count | min | max | mean | stdev | missing_count | invalid_or_nonfinite_count
pm1_ug_m3 | PM1.0 | µg/m³ | 129 | 0 | 3280.0 | 3499.0 | 3345.3023255813955 | 55.24145927357838 | 0 | 0
pm25_ug_m3 | PM2.5 | µg/m³ | 129 | 0 | 3280.0 | 3499.0 | 3345.3023255813955 | 55.24145927357838 | 0 | 0
pm10_ug_m3 | PM10 | µg/m³ | 129 | 0 | 3280.0 | 3499.0 | 3345.3023255813955 | 55.24145927357838 | 0 | 0
hcho_mg_m3 | 甲醛 HCHO | mg/m³ | 129 | 0 | 4.315 | 4.316 | 4.315666666666667 | 0.0004732423621497605 | 0 | 0
temperature_c | 温度 | °C | 129 | 0 | 20.8 | 21.2 | 21.058914728682172 | 0.10869424080647594 | 0 | 0
humidity_percent | 相对湿度 | % | 129 | 0 | 65.2 | 65.7 | 65.52480620155039 | 0.11252153110067419 | 0 | 0
