lihaolun201003/challenging-course/02_固件工程/数据包/有毒气体特定场景_20261028_144738/measurements.csv

timestamp_local | elapsed_s | frame | pm1_ug_m3 | pm25_ug_m3 | pm10_ug_m3 | hcho_mg_m3 | temperature_c | humidity_percent | firmware_version | sensor_error
2026-10-28T14:48:09.856+08:00 | 0.7958454000181518 | 34 | 3499 | 3499 | 3499 | 4.316 | 20.8 | 65.2 | 145 | 0
2026-10-28T14:48:10.763+08:00 | 1.702893000037875 | 35 | 3499 | 3499 | 3499 | 4.316 | 20.8 | 65.2 | 145 | 0
2026-10-28T14:48:11.672+08:00 | 2.6119619000237435 | 36 | 3471 | 3471 | 3471 | 4.315 | 20.9 | 65.3 | 145 | 0
2026-10-28T14:48:12.650+08:00 | 3.5899531000177376 | 37 | 3471 | 3471 | 3471 | 4.316 | 20.9 | 65.3 | 145 | 0
2026-10-28T14:48:13.561+08:00 | 4.5011212000390515 | 38 | 3471 | 3471 | 3471 | 4.316 | 20.9 | 65.3 | 145 | 0
2026-10-28T14:48:14.466+08:00 | 5.405891000002157 | 39 | 3463 | 3463 | 3463 | 4.315 | 20.9 | 65.3 | 145 | 0
2026-10-28T14:48:15.445+08:00 | 6.384780100022908 | 40 | 3463 | 3463 | 3463 | 4.316 | 20.9 | 65.4 | 145 | 0
2026-10-28T14:48:16.353+08:00 | 7.293118800036609 | 41 | 3463 | 3463 | 3463 | 4.316 | 20.9 | 65.4 | 145 | 0
2026-10-28T14:48:17.261+08:00 | 8.200814500043634 | 42 | 3463 | 3463 | 3463 | 4.315 | 20.9 | 65.3 | 145 | 0
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
