lihaolun201003/challenging-course/(commit log)

2026-10-10 整理前快照：原样保存 2477 个文件
2026-10-10 整理：分类归档 + 重命名 + 补索引文档（零删除）
    [文件清单_整理前.tsv, 文件清单_整理后.tsv]
2026-11-05 更新课程项目资料
    [01_上盖_带显示窗口.stl, 01_底座_带铜柱.stl, 02_上盖_备用版.stl, 02_底座_备用版.stl, all_readings.csv, diagnostics.csv, measurement_stats.csv, measurements.csv]
